quentinhqn/barduino/rapport de séance/rapports Armel/Armel_Séance_1.md

C'est la première séance pendant laquelle nous commençons à travailler sur notre projet.

Notre projet est un Barduino commencé par un autre groupe d'étudiants en 2016/2017.
Au début de la séance nous nous sommes demandés ce que nous avions à faire sur le projet. Nous shouaitons remplacer les vis qui permettent
l'avancée du plateau supportant le verre par des courroies, créer une commande vocale (nous aurons seulement besoin de notre voix pour faire
le choix du cocktail)et ajouter des leds pour rendre les support plus joli. 
Ensuite nous avons répartis les tâches et fait un planning. Je m'occuperais surtout de la partie codage des moteurs alors que Quentin 
s'occupera de la commande vocale et de l'installation des courroies. Pour la dernière séance nous ferons un point esthétique avec les diodes 
si nous avons le temps.
Comme nous ne savons pas quand les courroies arriveront et que le gros du travail sera de les installer, nous commençons par la commande 
vocale pour Quentin et par essayer de comprendre le fonctionnement des moteurs à notre disposition pour ma part. Comme le cablage était 
très compliqué, j'ai tout débranché. Ensuite, j'ai dévissé une grande partie du projet pour récupérer un moteur, l'identifier et le faire 
marcher. Il s'agit du moteur nema17 qui permet le déplacement du socle sur le grand axe.
La question qui se pose maintenant est la suivante: Est-ce qu'un moteur continu est plus intéressant dans notre cas qu'un moteur pas à pas.
Personellement, je ne vois pas le problème avec le moteur pas à pas. La vitesse peut être assez élevée, il faut juste voir si il aura assez 
de force pour déplacer le socle quand on ajoutera la courroie.

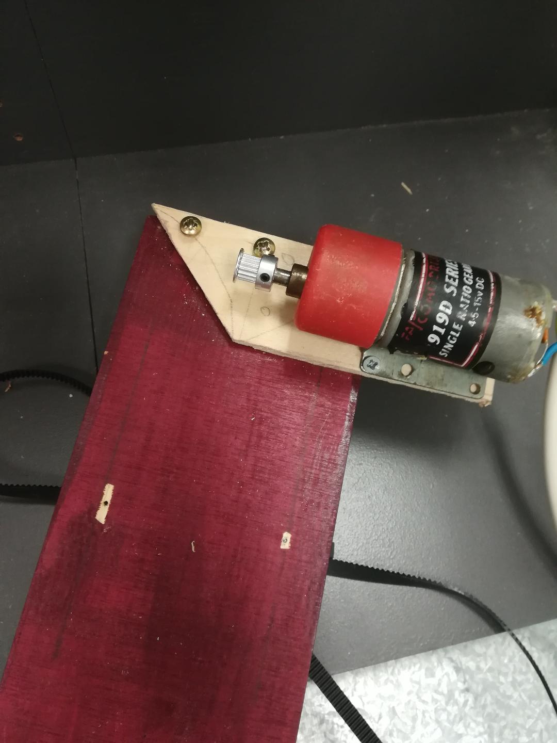
[picture p18: rapport de s-ance/2ème moteur.jpg]
test
