quentinhqn/barduino/rapport de s-ance/Classeur1.xlsx

 | seance | 1 | 2 | 3 | 4
travail |  |  |  |  |  | Armel
 |  |  |  |  |  | Quentin
courroie construction |  |  |  |  |  | les deux
courroie (code)
code en géneral
commande vocale
organisation
esthetique
