quentinhqn/barduino/rapport de s-ance/encoche dans le petit plateau.jpg

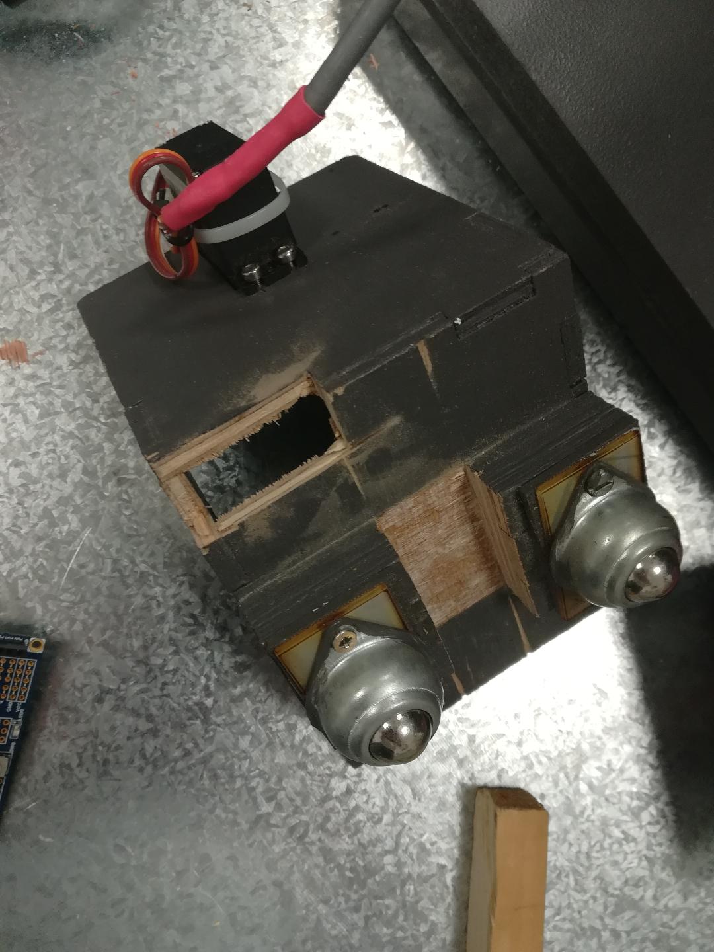
rapport de s-ance/encoche dans le petit plateau.jpg
