quentinhqn/barduino/rapport de s-ance/fixation courroie.jpg

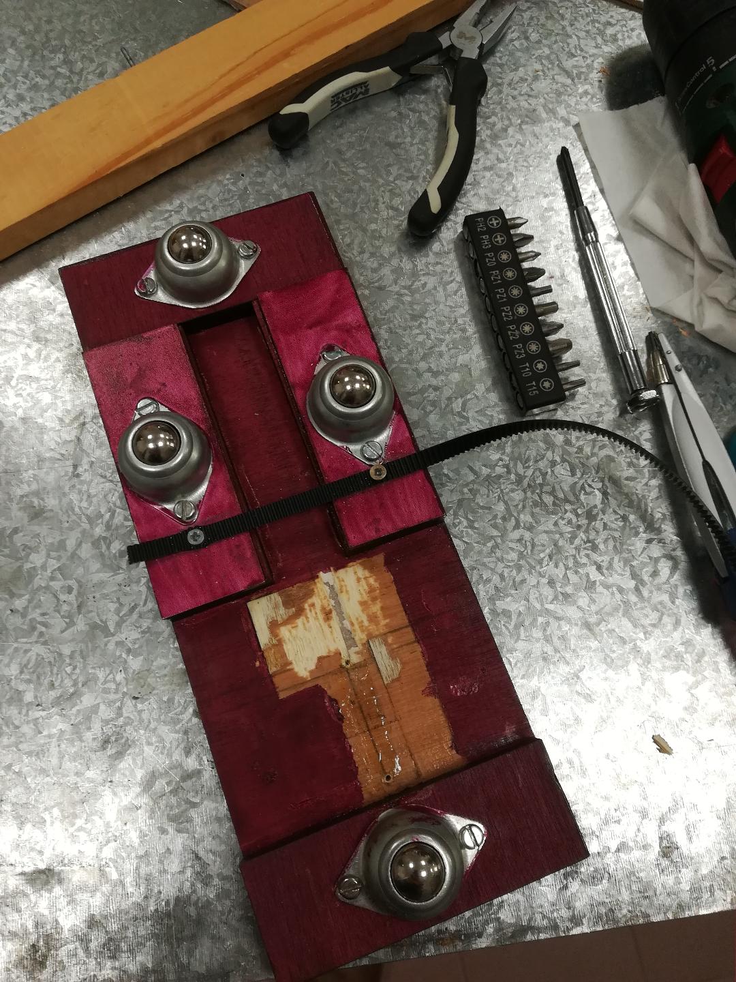
rapport de s-ance/fixation courroie.jpg
