quentinhqn/barduino/rapport de s-ance/fixation moteur.jpg

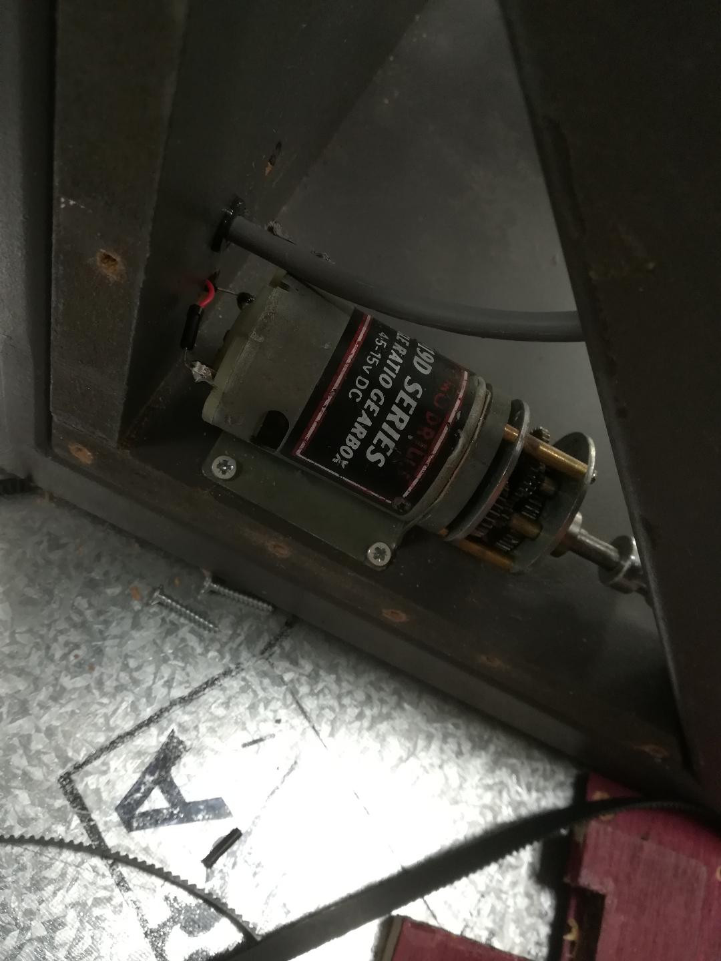
rapport de s-ance/fixation moteur.jpg
