quentinhqn/barduino/rapport de s-ance/planche réfractaire d'onde.jpg

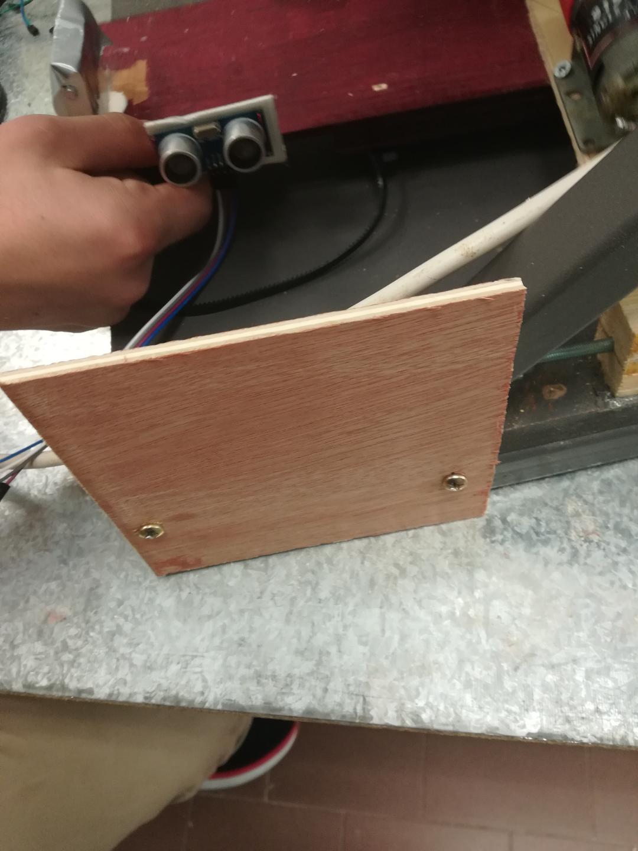
rapport de s-ance/planche réfractaire d'onde.jpg
