quentinhqn/barduino/(commit log)

2018-12-14 Create rapport de séance
2018-12-14 Rename rapport de séance to rapport de séance
2018-12-14 Update rapport de séance
2018-12-14 Rename rapport de séance to rapport de s-ance/séance 1
2019-03-15 Rename rapport de s-ance/Armel_Séance_1.md to rapport de séance/rapports Armel/Armel_Séance_1.md
2019-03-15 Rename rapport de s-ance/Armel_Séance_2 to rapport de séance/rapports Armel/Armel_Séance_2
2019-03-15 Rename rapport de s-ance/Armel_Séance_3 to rapport de séance/rapports Armel/Armel_Séance_3
2019-03-15 Rename rapport de s-ance/Armel_Séance_4 to rapport de séance/rapports Armel/Armel_Séance_4
2019-03-15 Rename rapport de s-ance/Armel_séance_5 to rapport de séance/rapports Armel/Armel_séance_5
2019-03-15 Rename rapport de s-ance/Armel_séance_6 to rapport de séance/rapports Armel/Armel_séance_6
2019-03-15 Rename rapport de s-ance/Armel_séance_7 to rapport de séance/rapports Armel/Armel_séance_7
2019-03-15 Rename rapport de s-ance/Armel_séance_8 to rapport de séance/rapports Armel/Armel_séance_8
2019-03-15 Rename rapport de s-ance/test_servo.ino to Code/test_servo.ino
2019-03-15 Rename rapport de s-ance/code_final.ino to Code/code_final.ino
2019-03-15 Rename rapport de s-ance/retour_position.ino to Code/retour_position.ino
2019-03-15 Rename rapport de s-ance/séance 1 to rapport de séance/rapports Quentin/séance 1
2019-03-15 Rename rapport de s-ance/seance 2 to rapport de séance/rapports Quentin/seance 2
2019-03-15 Rename rapport de s-ance/sceance 7 to rapport de séance/rapports Quentin/seance 7
2019-03-15 Rename rapport de s-ance/seance 3 to rapport de séance/rapports Quentin/seance 3
2019-03-15 Rename rapport de s-ance/seance 4 to rapport de séance/rapports Quentin/seance 4
2019-03-15 Rename rapport de s-ance/seance 5 to rapport de séance/rapports Quentin/seance 5
2019-03-15 Rename rapport de s-ance/séance 8 to rapport de séance/rapports Quentin/séance 8
2019-03-18 Create test sonar
2019-03-18 Rename retour_position.ino to position du plateau.ino
